EmilPtr/LimeArm-MKI/README.md

# LimeArm MKI
LimeArm MKI is a 4-bar-linkage style robotic arm I created to redeem myself after several failed robotic arm attempts. The goal of this was to make this arm without spending a single dime from my pocket, and I have stayed through to that commitment till the very end. Overall, I'm very impressed with what I have made and am quite proud of it!

Being a 4-bar linkage style arm, it has no real-world application besides education (It did educate me well though), MKII is gonna be a REAL 4 DOF arm!

## Process
I used Onshape for the entire duration of this CAD, I luv Onshape so much it is the best CAD software ever!

I first had to study 4 bar linkages, I had little idea how this works, but after staring intently at the EEZYBOT Arm for a great many hours, I got it perfectly!! I even made a sketch in onshape to test it. Funny how if you stare at something long enough youll eventually get it!

After I got that figured out, I continued to use the EEZYBOT arm as a source of inspiration, while they are similar like car and carpet, there are a lot of parallels with the EEZYBOT. 

CAD is CAD, I printed a lot of stuff during the design process to make sure everything lines up and fits in the real world, It was awfully smooth for something physical, I think its the smoothest a project has ever gone for me!

However, I did get thoroughly flamed by my robotics team's CAD division for awful habits and practices...

After building, I realized it could barely lift anything more than itself, which made me cut down the size by approximately half!

## Photos
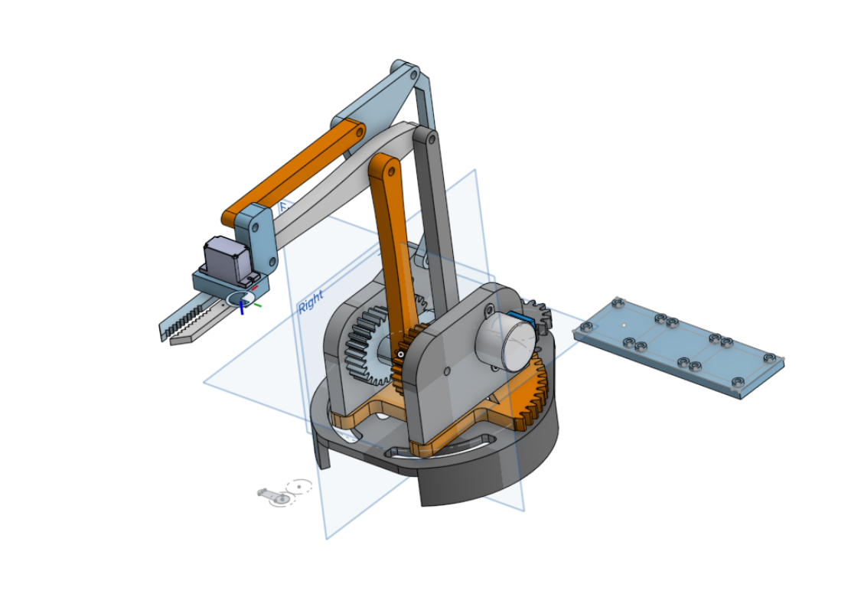
[picture p1: PICTURES/Screenshot_20260525_231724.png]
 
First iteration before size down

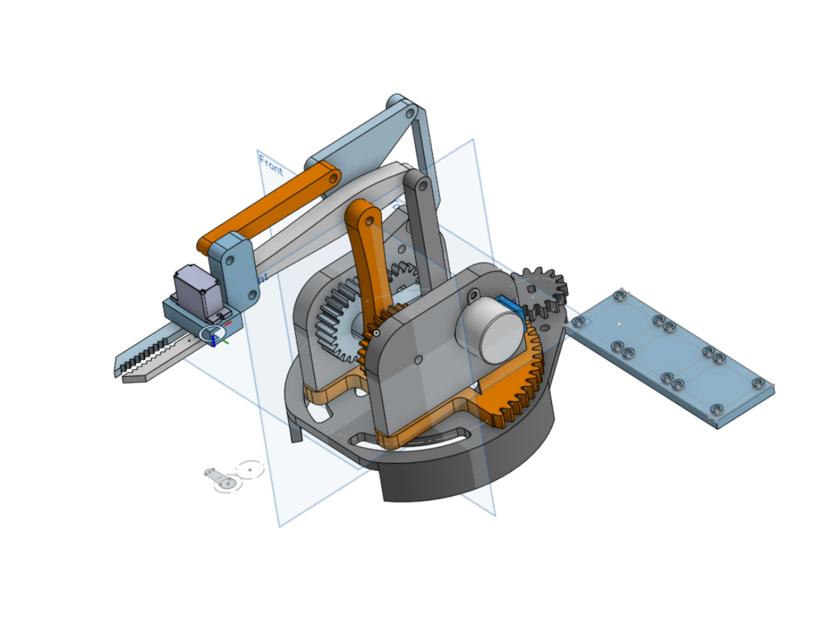
[picture p2: PICTURES/Screenshot_20260526_222849.png]

Downsized

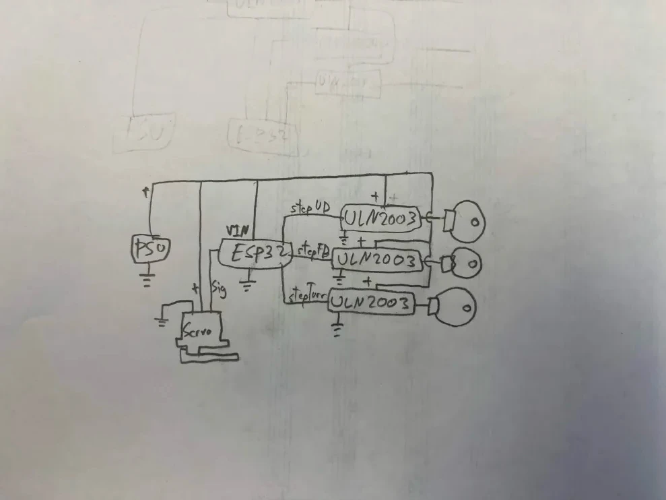
[picture p3: PICTURES/CIRCUIT.webp]
circuit diagram

Circuit Diagram

## BOM
|Part Name |Amount|Link to Part |Obtained|Price |
|---|---|---|---|---|
|28BYJ-48 Stepper Motor|3 |https://www.aliexpress.com/item/1005009331799965.html|Yes |$9.99 |
|ULN2003 Stepper Driver|3 |https://www.aliexpress.com/item/1005009331799965.html|Yes |Comes with above|
|ESP32 |1 |https://www.aliexpress.com/item/1005008806241325.html|Yes |$6.99 |
|MG90 Micro Servo |1 |https://www.aliexpress.com/item/32438050796.html |Yes |$2.59 |
|Assorted Wires |N/A |N/A |Yes |Negligible |
|3DP Parts |N/A |N/A |Yes |Negligible |
| | | | | |
| | | | |Total Cost |
| | | | |$19.57 |

## Build
### Cool photos yay!!! :D
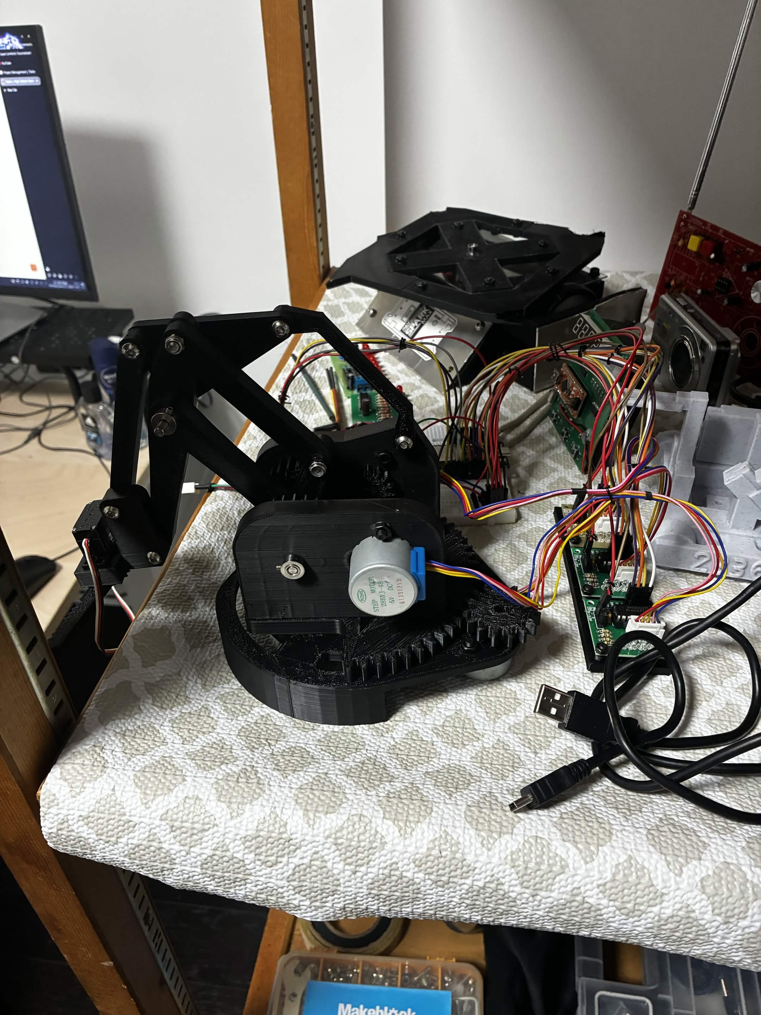
[picture p4: PICTURES/IMG_0132.jpg]

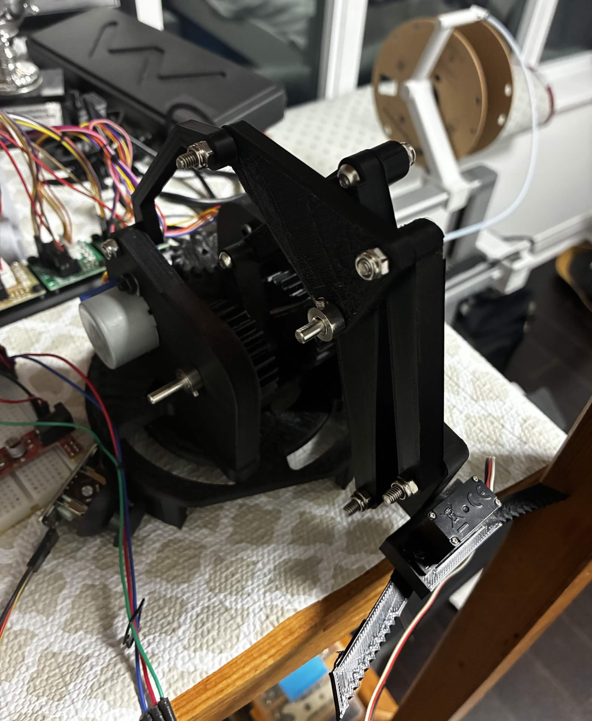
[picture p5: PICTURES/IMG_0133.jpg]

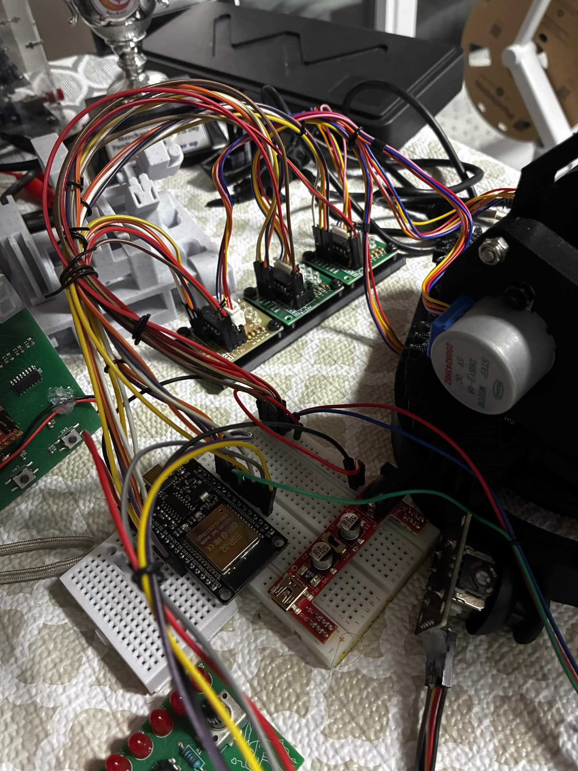
[picture p6: PICTURES/IMG_0135.jpg]

## Video is here:
https://drive.google.com/file/d/1GkwxV1Ix10FxGRyfBV68P5_X3fs_jpAJ/view?usp=sharing
