EmilPtr/LimeArm-MKI/CAD_FILES/LimeArm MKI - Main Arm.step

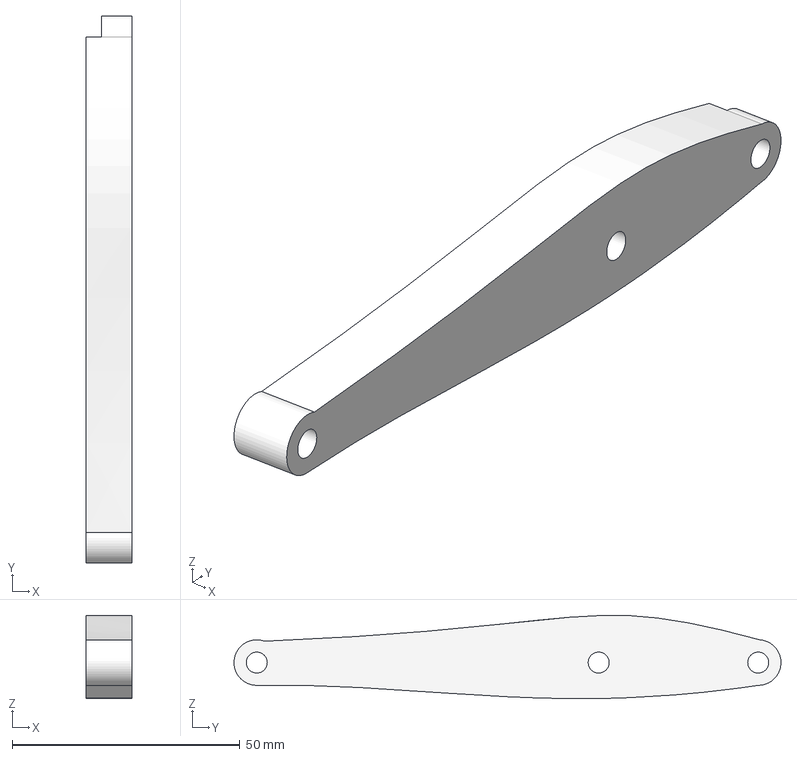
[picture p7: CAD file, 2026-05-27]
CAD_FILES/LimeArm MKI - Main Arm.step
10.0 x 120.0 x 18.3 mm
