EmilPtr/LimeArm-MKI/CAD_FILES/LimeArm MKI - Main Dead Link.step

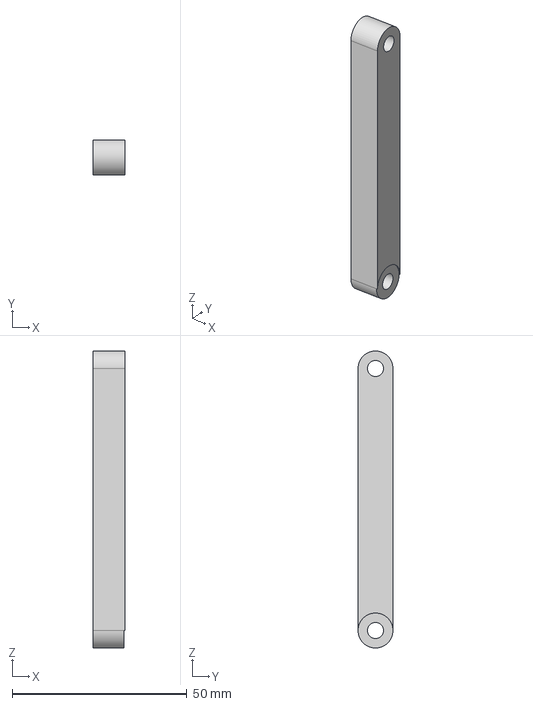
[picture p8: CAD file, 2026-05-27]
CAD_FILES/LimeArm MKI - Main Dead Link.step
9.20 x 10.0 x 85.0 mm
