EmilPtr/LimeArm-MKI/CAD_FILES/LimeArm MKI - Turret Gear Assembly.step

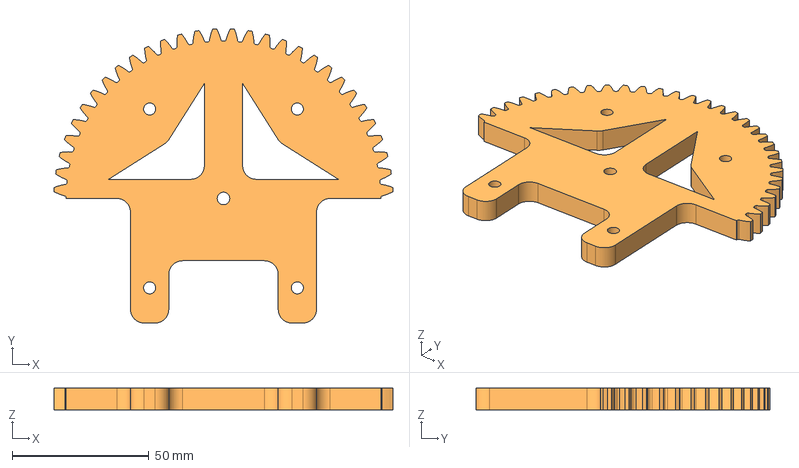
[picture p9: CAD file, 2026-05-27]
CAD_FILES/LimeArm MKI - Turret Gear Assembly.step
123.9 x 107.5 x 8.00 mm
