EmilPtr/LimeArm-MKI/CAD_FILES/LimeArm MKI - Base-Elbow Leveling Link.step

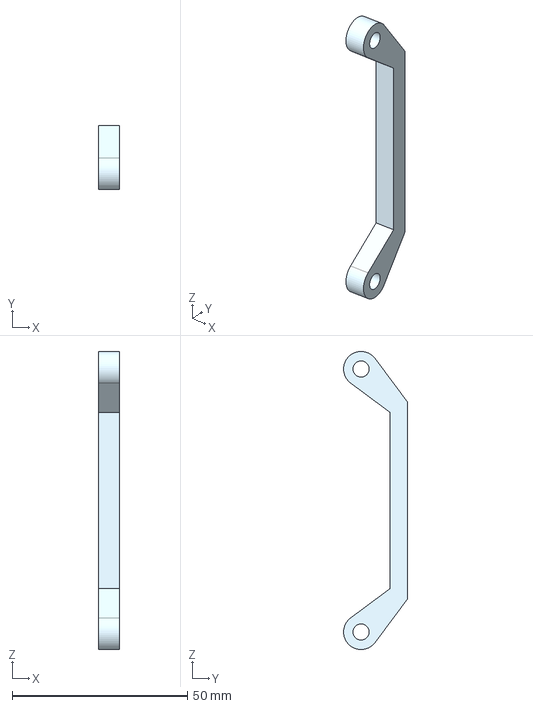
[picture p10: CAD file, 2026-05-27]
CAD_FILES/LimeArm MKI - Base-Elbow Leveling Link.step
6.00 x 18.2 x 85.0 mm
