EmilPtr/LimeArm-MKI/CAD_FILES/LimeArm MKI - Part 37.step

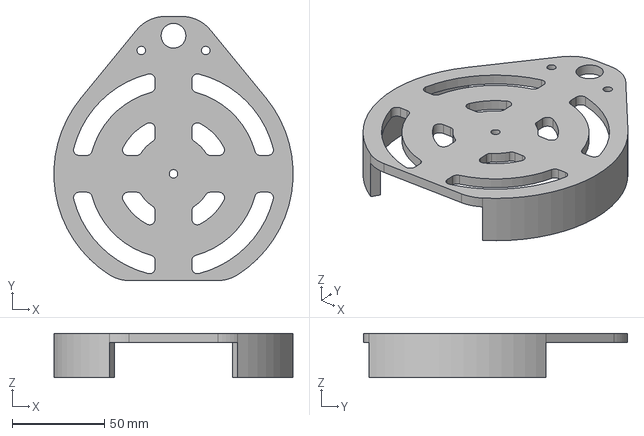
[picture p11: CAD file, 2026-05-27]
CAD_FILES/LimeArm MKI - Part 37.step
129.8 x 143.5 x 24.0 mm
