EmilPtr/LimeArm-MKI/CAD_FILES/LimeArm MKI - Support Level Link.step

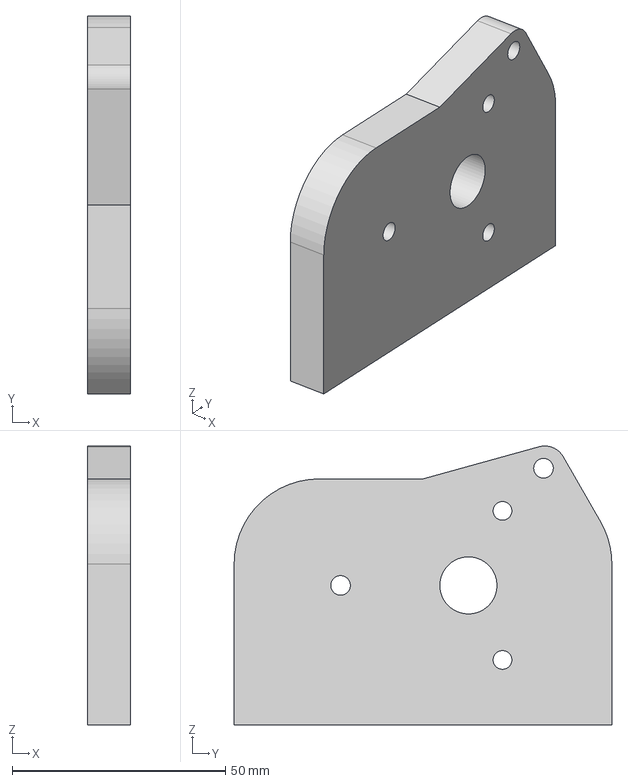
[picture p12: CAD file, 2026-05-27]
CAD_FILES/LimeArm MKI - Support Level Link.step
10.0 x 88.7 x 65.5 mm
