EmilPtr/LimeArm-MKI/CAD_FILES/LimeArm MKI - Driving Claw.step

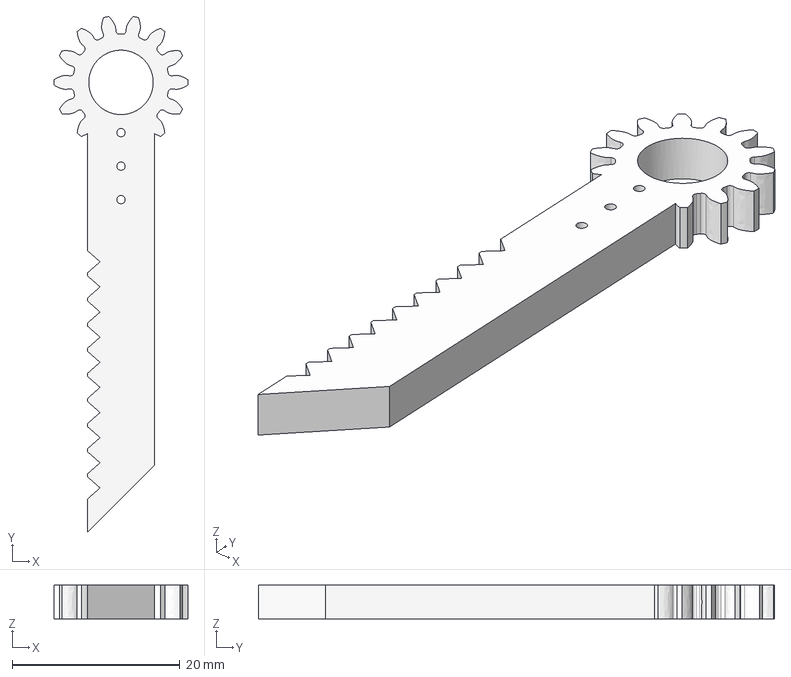
[picture p13: CAD file, 2026-05-27]
CAD_FILES/LimeArm MKI - Driving Claw.step
16.0 x 61.6 x 4.00 mm
