EmilPtr/LimeArm-MKI/CAD_FILES/LimeArm MKI - X Drive.step

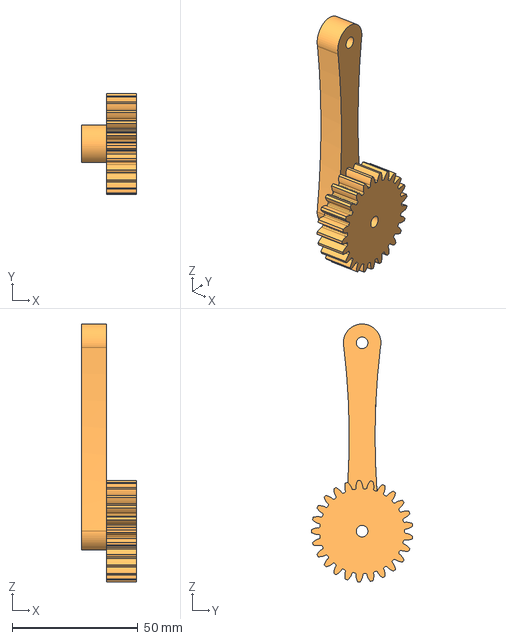
[picture p14: CAD file, 2026-05-27]
CAD_FILES/LimeArm MKI - X Drive.step
22.0 x 40.4 x 102.7 mm
