EmilPtr/LimeArm-MKI/CAD_FILES/LimeArm MKI - Turret Pinion.step

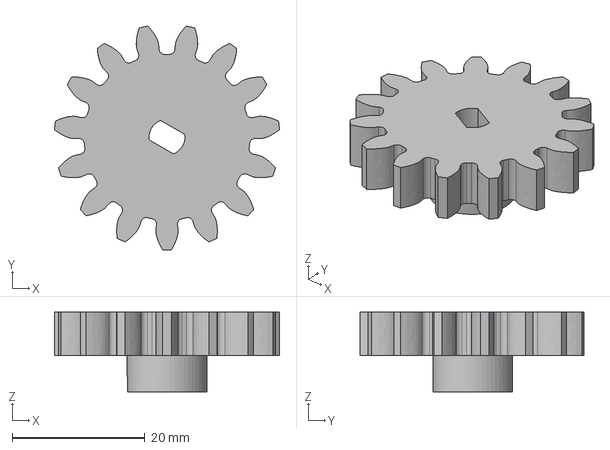
[picture p15: CAD file, 2026-05-27]
CAD_FILES/LimeArm MKI - Turret Pinion.step
33.9 x 33.8 x 12.0 mm
