EmilPtr/LimeArm-MKI/CAD_FILES/LimeArm MKI - Support.step

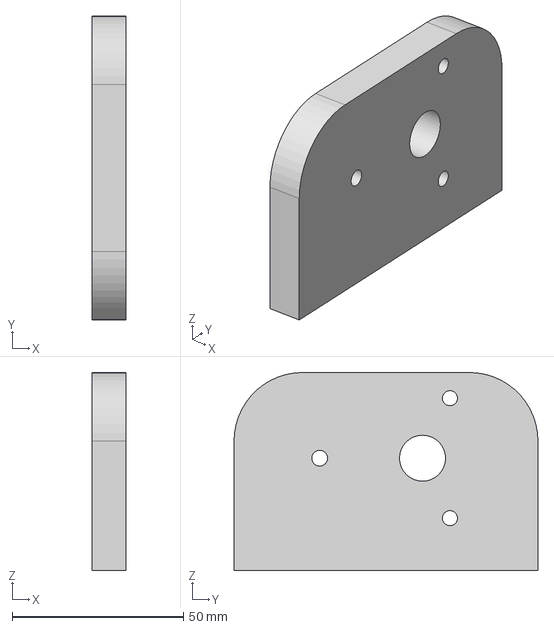
[picture p16: CAD file, 2026-05-27]
CAD_FILES/LimeArm MKI - Support.step
10.0 x 88.7 x 57.8 mm
