EmilPtr/LimeArm-MKI/CAD_FILES/LimeArm MKI - Part 48.step

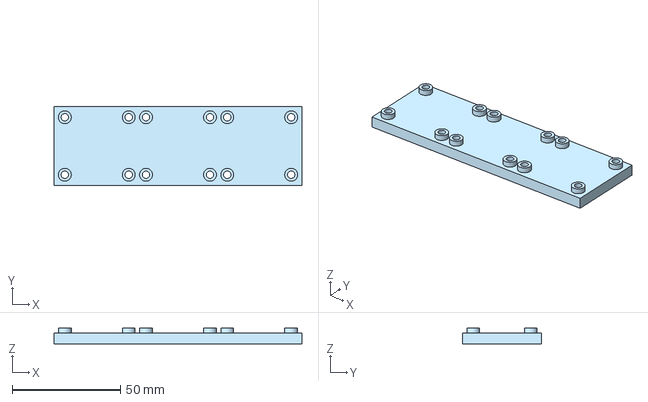
[picture p17: CAD file, 2026-05-27]
CAD_FILES/LimeArm MKI - Part 48.step
114.8 x 36.6 x 7.40 mm
