EmilPtr/LimeArm-MKI/CAD_FILES/LimeArm MKI - Claw Mount.step

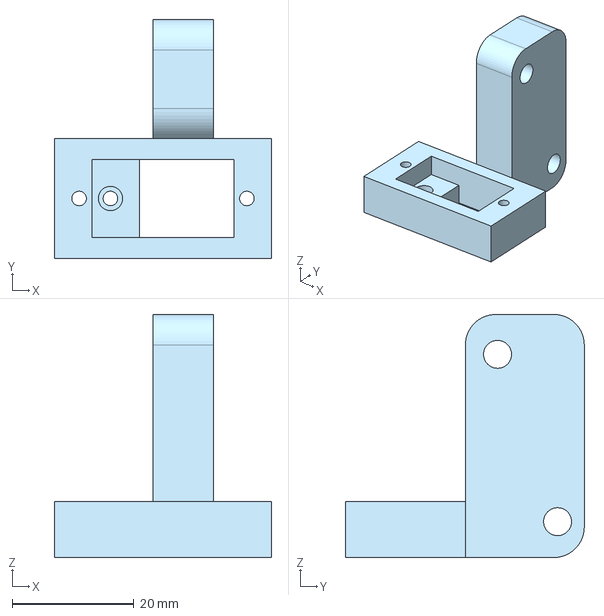
[picture p18: CAD file, 2026-05-27]
CAD_FILES/LimeArm MKI - Claw Mount.step
35.8 x 39.3 x 40.0 mm
