EmilPtr/LimeArm-MKI/CAD_FILES/LimeArm MKI - Y Drive.step

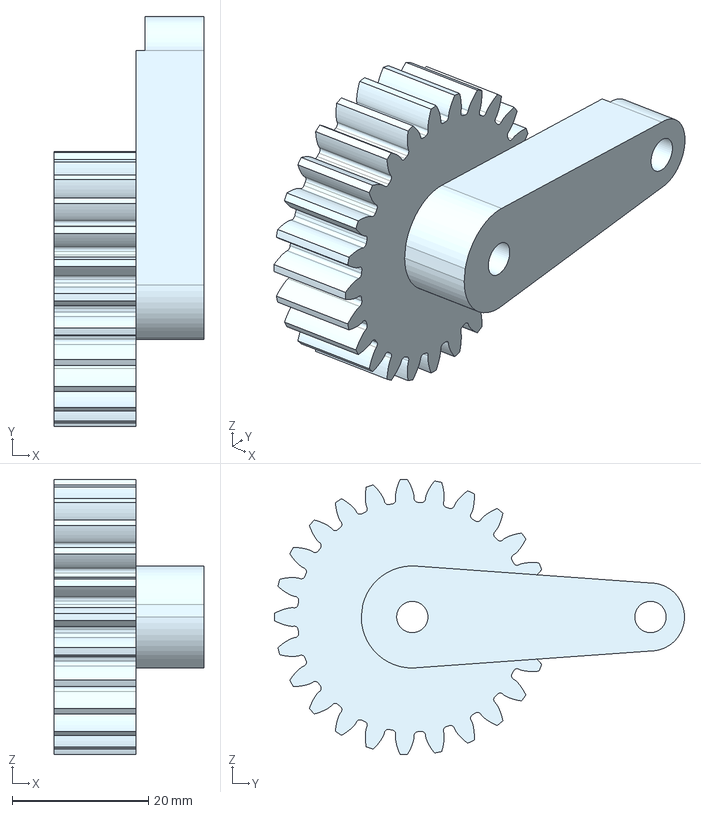
[picture p19: CAD file, 2026-05-27]
CAD_FILES/LimeArm MKI - Y Drive.step
22.0 x 60.2 x 40.5 mm
