EmilPtr/LimeArm-MKI/CAD_FILES/LimeArm MKI - Pinion.step

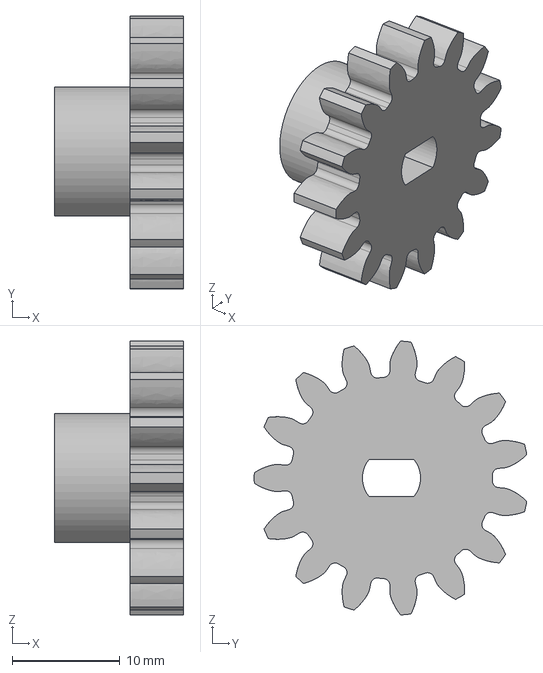
[picture p20: CAD file, 2026-05-27]
CAD_FILES/LimeArm MKI - Pinion.step
12.0 x 25.3 x 25.4 mm
