EmilPtr/LimeArm-MKI/CAD_FILES/LimeArm MKI - Leveling Triangle.step

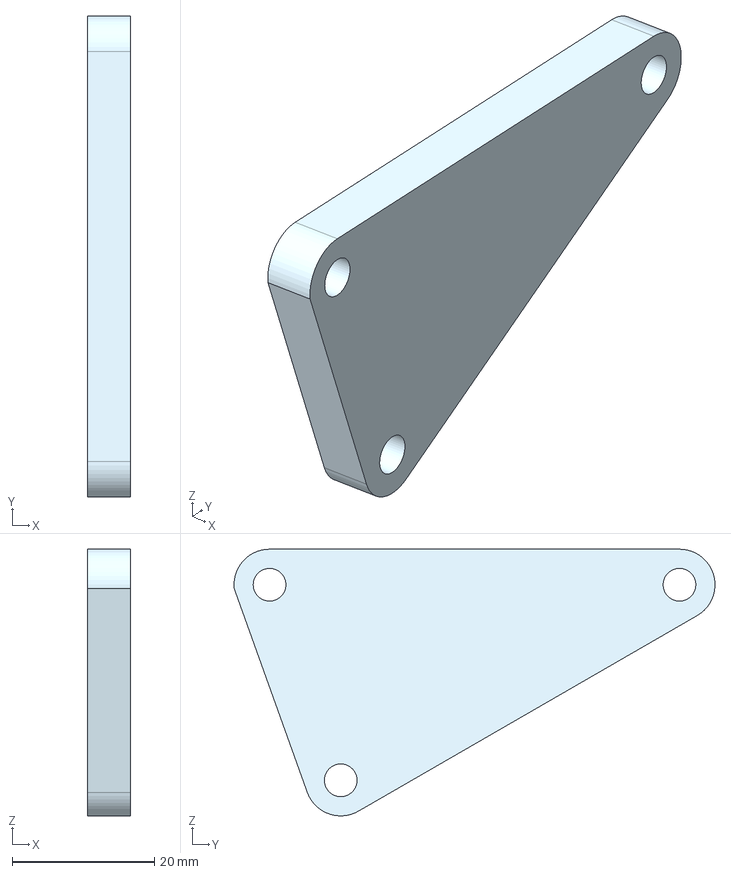
[picture p21: CAD file, 2026-05-27]
CAD_FILES/LimeArm MKI - Leveling Triangle.step
6.00 x 67.6 x 37.5 mm
