EmilPtr/LimeArm-MKI/CAD_FILES/LimeArm MKI - Elbow-Claw Leveling Link.step

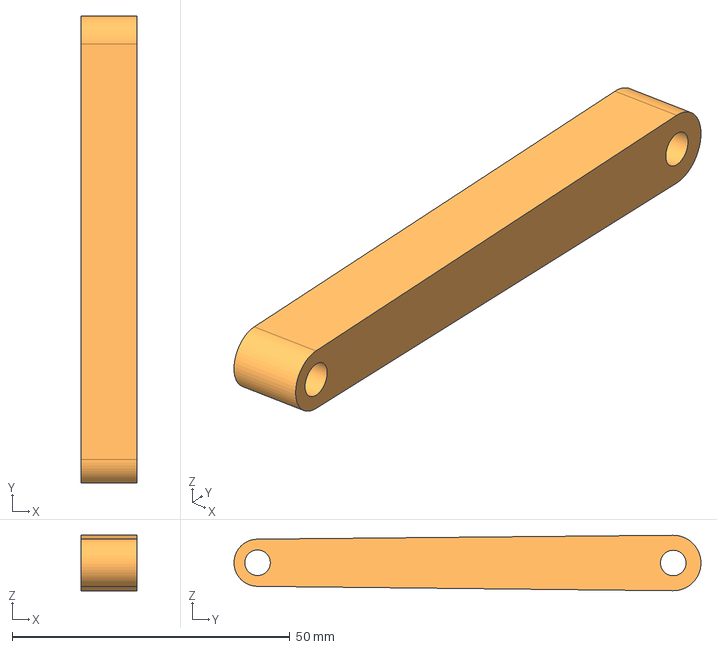
[picture p22: CAD file, 2026-05-27]
CAD_FILES/LimeArm MKI - Elbow-Claw Leveling Link.step
10.0 x 84.1 x 10.00 mm
