EmilPtr/LimeArm-MKI/(list of files, cad)

Other CAD files:
CAD_FILES/LimeArm MKI - Driven Claw.step
