EmilPtr/LimeArm-MKI/(commit log)

2026-05-27 started, basic joystick control, no turret nor claw yet
2026-05-27 added cad files
    [LimeArm MKI - Base-Elbow Leveling Link.step, LimeArm MKI - Claw Mount.step, LimeArm MKI - Driven Claw.step, LimeArm MKI - Driving Claw.step, LimeArm MKI - Elbow-Claw Leveling Link.step, LimeArm MKI - Leveling Triangle.step, LimeArm MKI - Main Arm.step, LimeArm MKI - Main Dead Link.step]
2026-05-28 added circuit diagram
2026-06-10 added bom
    [LimeArm MKI BOM.csv]
